starwarsfan/KNX-Status-Display/Images/PleaseWait.png

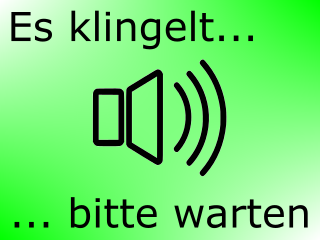
Images/PleaseWait.png
