starwarsfan/KNX-Status-Display/Images/Keypad.png

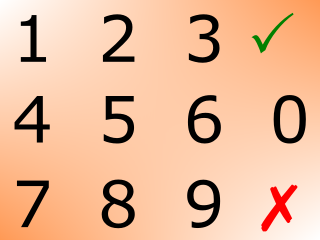
Images/Keypad.png
