starwarsfan/KNX-Status-Display/Images/FingerNotRecognized.png

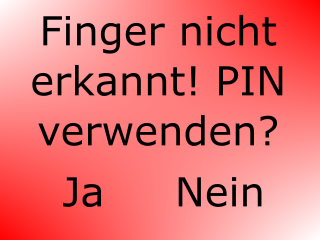
Images/FingerNotRecognized.png
