starwarsfan/KNX-Status-Display/Images/Welcome.png

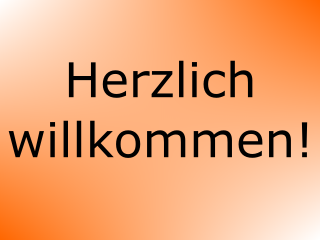
Images/Welcome.png
